parkourlrc/pcb-Szymon423--Mesa-7i96s-P1-Port-BOB-06d0a3034d/01-Hardware/db25-bob-io/pcb.step

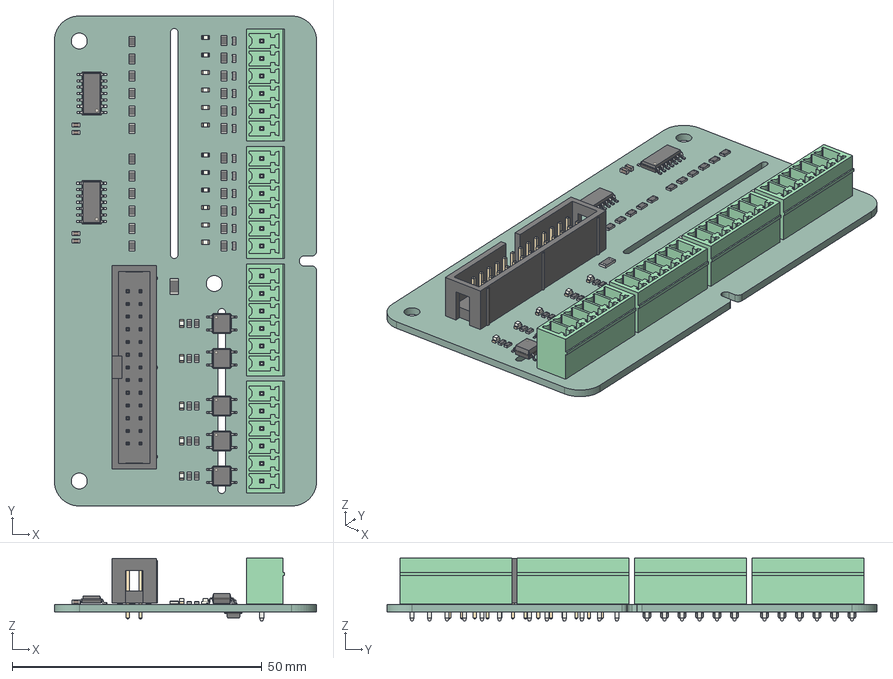
[picture p4: CAD file, 2026-04-16]
01-Hardware/db25-bob-io/pcb.step
52.5 x 98.0 x 12.6 mm
L_0603_1608Metric x 12
R_0805_2012Metric x 24
PhoenixContact_MCV_1,5_6-G-3.5_1x06_P3.50mm_Vertical x 4
C_0603_1608Metric x 4
LED_0603_1608Metric x 17
R_0603_1608Metric x 10
SOP-4_3.8x4.1mm_P2.54mm x 5
Fuse_1206_3216Metric
SO-14_3.9x8.65mm_P1.27mm x 2
IDC-Header_2x13_P2.54mm_Vertical
D_SOD-123F x 12
db25-bob-io_PCB
