parkourlrc/pcb-Szymon423--Mesa-7i96s-P1-Port-BOB-06d0a3034d/02-Mounting-Plate/3D-Printing/print.3mf

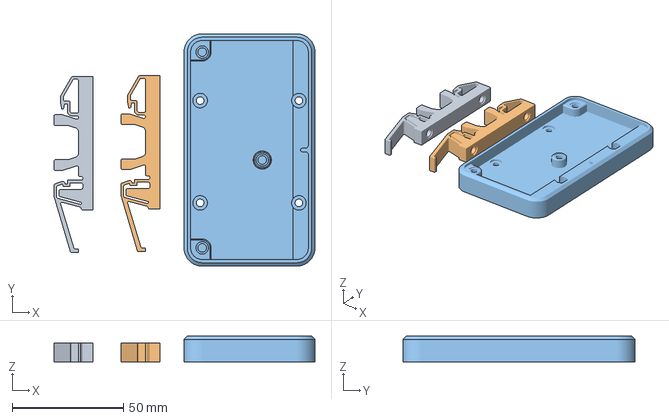
[picture p5: CAD file, 2026-10-19]
02-Mounting-Plate/3D-Printing/print.3mf
117.3 x 104.4 x 11.6 mm
02.stl
01.stl
