parkourlrc/pcb-Szymon423--Mesa-7i96s-P1-Port-BOB-06d0a3034d/02-Mounting-Plate/3D-Printing/01.stl

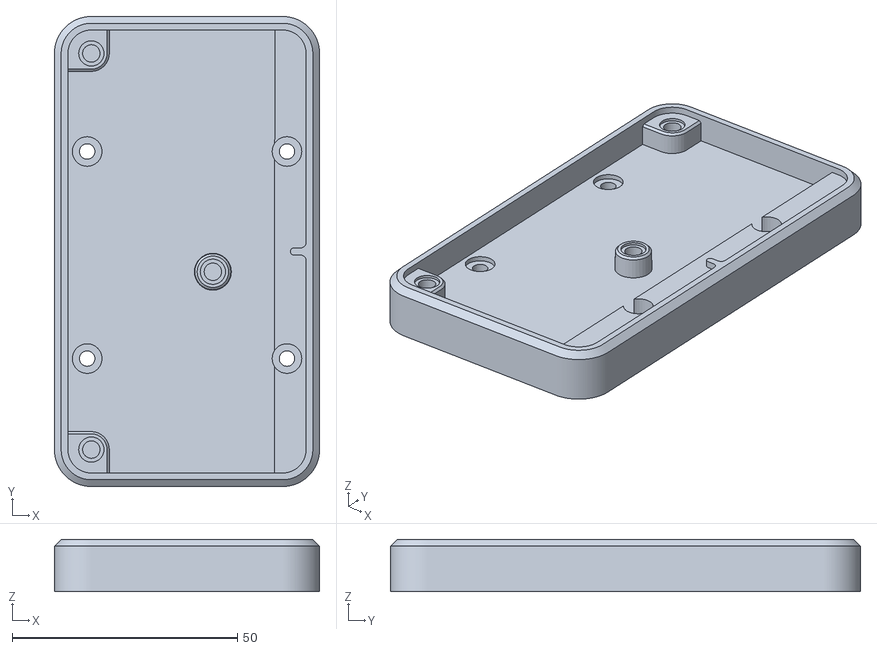
[picture p6: CAD file, 2026-04-16]
02-Mounting-Plate/3D-Printing/01.stl
58.9 x 104.4 x 11.6
