parkourlrc/pcb-Szymon423--Mesa-7i96s-P1-Port-BOB-06d0a3034d/02-Mounting-Plate/3D-Printing/02.stl

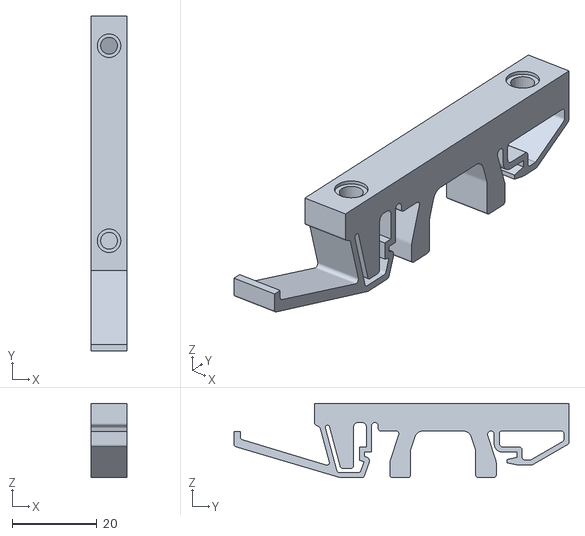
[picture p7: CAD file, 2026-04-16]
02-Mounting-Plate/3D-Printing/02.stl
8.52 x 79.0 x 17.5
