parkourlrc/pcb-Szymon423--Mesa-7i96s-P1-Port-BOB-06d0a3034d/(list of files, cad)

Other CAD files:
02-Mounting-Plate/model.blend
