parkourlrc/pcb-Szymon423--Mesa-7i96s-P1-Port-BOB-06d0a3034d/01-Hardware/db25-bob-io/db25-bob-io.kicad_pcb

## KiCad design 01-Hardware/db25-bob-io/db25-bob-io.kicad_pcb (2026-04-16)

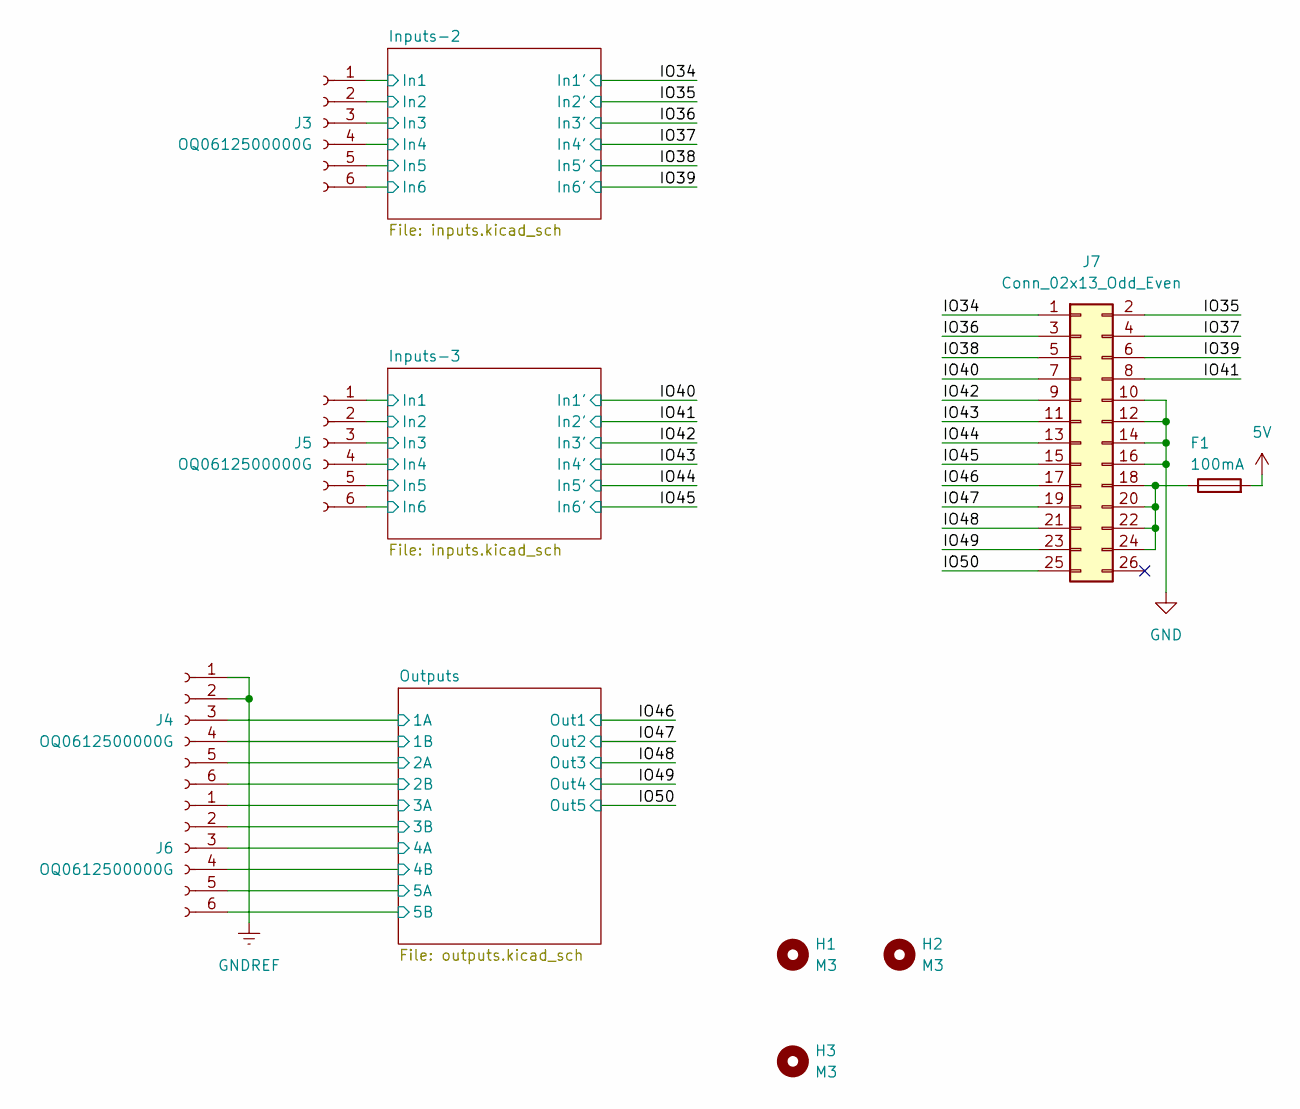
[picture p8: schematic db25-bob-io.kicad_sch]

Parts:
F1: 100mA; Fuse_1206_3216Metric
H1, H2, H3: M3; MountingHole_3.2mm_M3
J3, J4, J5, J6: OQ0612500000G; PhoenixContact_MCV_1,5_6-G-3.5_1x06_P3.50mm_Vertical
J7: Conn_02x13_Odd_Even; IDC-Header_2x13_P2.54mm_Vertical

Connections:
5V: F1.2; also elsewhere on the board
/IO34: J7.1; also elsewhere on the board
/IO35: J7.2; also elsewhere on the board
/IO36: J7.3; also elsewhere on the board
/IO37: J7.4; also elsewhere on the board
/IO38: J7.5; also elsewhere on the board
/IO39: J7.6; also elsewhere on the board
/IO40: J7.7; also elsewhere on the board
/IO41: J7.8; also elsewhere on the board
/IO42: J7.9; also elsewhere on the board
/IO43: J7.11; also elsewhere on the board
/IO44: J7.13; also elsewhere on the board
/IO45: J7.15; also elsewhere on the board
/IO46: J7.17; also elsewhere on the board
/IO47: J7.19; also elsewhere on the board
/IO48: J7.21; also elsewhere on the board
/IO49: J7.23; also elsewhere on the board
/IO50: J7.25; also elsewhere on the board
/Inputs-2/In1: J3.1; also elsewhere on the board
/Inputs-2/In2: J3.2; also elsewhere on the board
/Inputs-2/In3: J3.3; also elsewhere on the board
/Inputs-2/In4: J3.4; also elsewhere on the board
/Inputs-2/In5: J3.5; also elsewhere on the board
/Inputs-2/In6: J3.6; also elsewhere on the board
/Inputs-3/In1: J5.1; also elsewhere on the board
/Inputs-3/In2: J5.2; also elsewhere on the board
/Inputs-3/In3: J5.3; also elsewhere on the board
/Inputs-3/In4: J5.4; also elsewhere on the board
/Inputs-3/In5: J5.5; also elsewhere on the board
/Inputs-3/In6: J5.6; also elsewhere on the board
/Outputs/1A: J4.3; also elsewhere on the board
/Outputs/1B: J4.4; also elsewhere on the board
/Outputs/2A: J4.5; also elsewhere on the board
/Outputs/2B: J4.6; also elsewhere on the board
/Outputs/3A: J6.1; also elsewhere on the board
/Outputs/3B: J6.2; also elsewhere on the board
/Outputs/4A: J6.3; also elsewhere on the board
/Outputs/4B: J6.4; also elsewhere on the board
/Outputs/5A: J6.5; also elsewhere on the board
/Outputs/5B: J6.6; also elsewhere on the board
GND: J7.10, J7.12, J7.14, J7.16; also elsewhere on the board
GNDREF: J4.1, J4.2; also elsewhere on the board
unnamed: F1.1, J7.18, J7.20, J7.22, J7.24

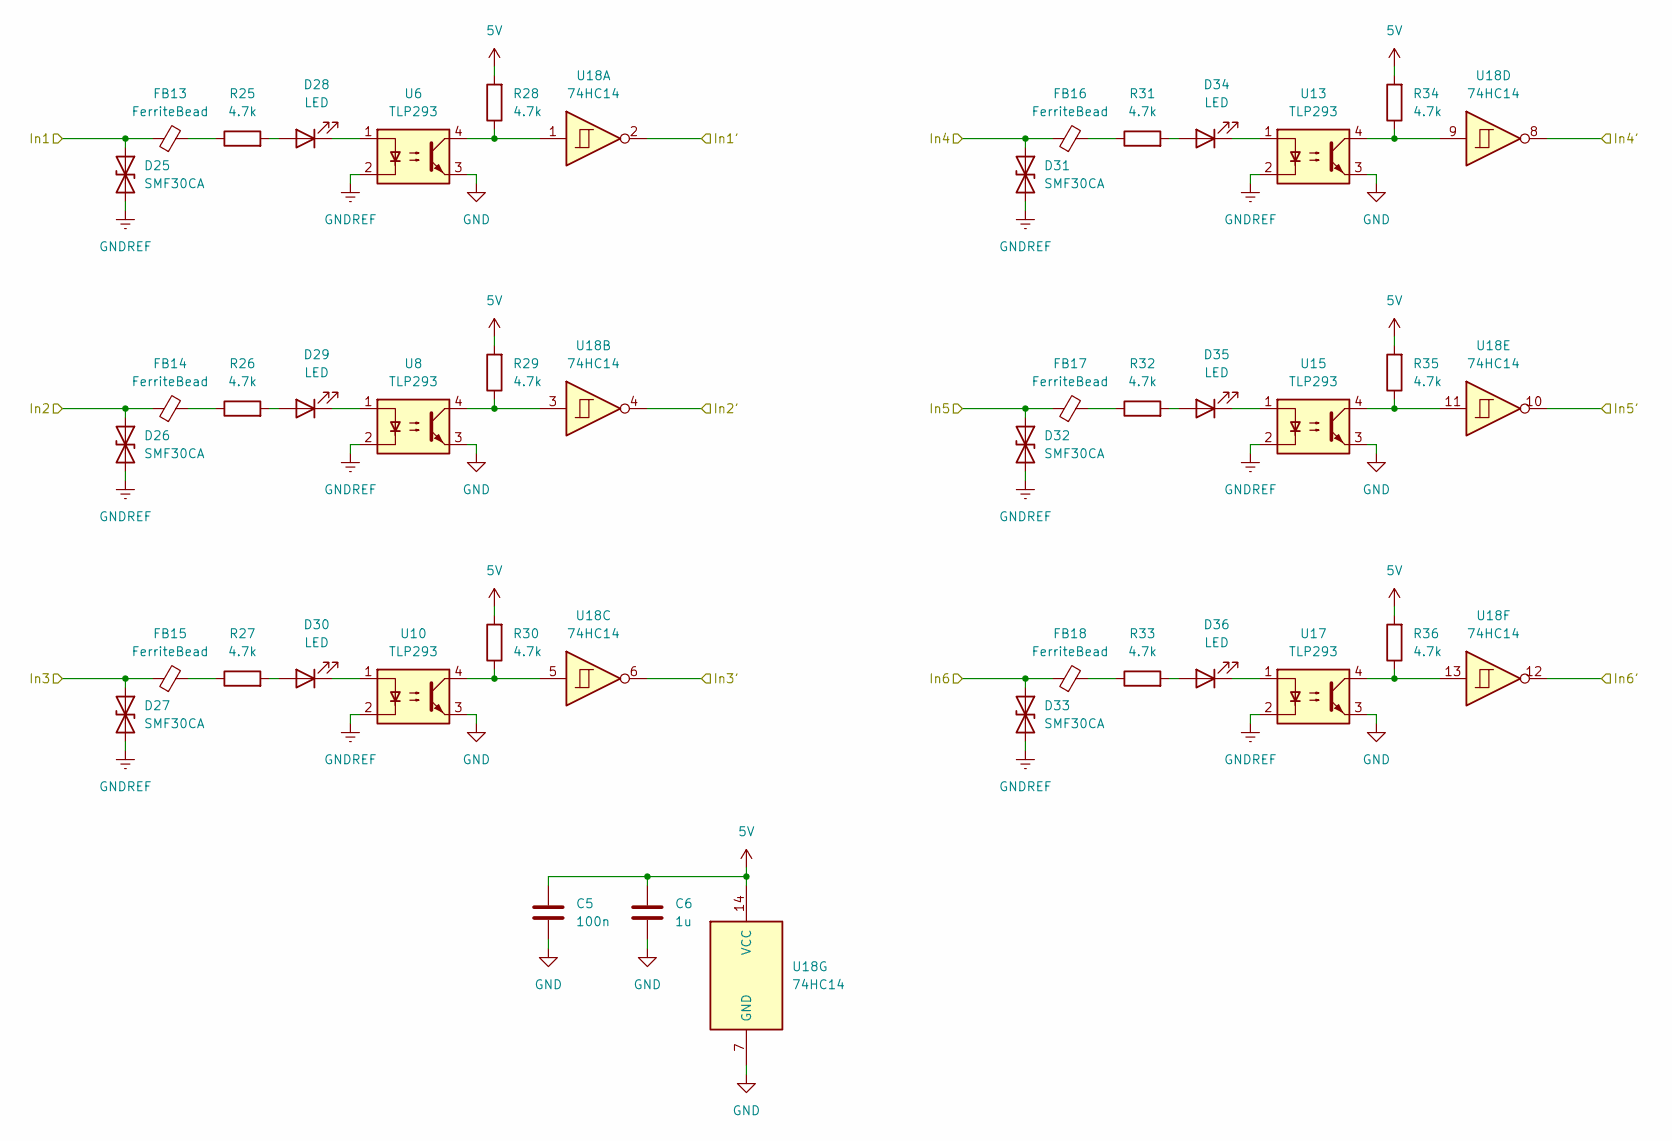
[picture p9: schematic inputs.kicad_sch]

Parts:
C5: 100n; C_0603_1608Metric
C6: 1u; C_0603_1608Metric
D25, D26, D27, D31, D32, D33: SMF30CA; D_SOD-123F
D28, D29, D30, D34, D35, D36: LED; LED_0603_1608Metric
FB13, FB14, FB15, FB16, FB17, FB18: FerriteBead; L_0603_1608Metric
R25, R26, R27, R28, R29, R30, R31, R32, R33, R34, R35, R36: 4.7k; R_0805_2012Metric
U6, U8, U10, U13, U15, U17: TLP293; SOIC-4_4.55x2.6mm_P1.27mm
U18: 74HC14; SO-14_3.9x8.65mm_P1.27mm

Connections:
5V: C5.1, C6.1, R28.2, R29.2, R30.2, R34.2, R35.2, R36.2, U18.14 (VCC); also elsewhere on the board
/IO40: U18.2; also elsewhere on the board
/IO41: U18.4; also elsewhere on the board
/IO42: U18.6; also elsewhere on the board
/IO43: U18.8; also elsewhere on the board
/IO44: U18.10; also elsewhere on the board
/IO45: U18.12; also elsewhere on the board
/Inputs-3/In1: D25.1 (A1), FB13.1; also elsewhere on the board
/Inputs-3/In2: D26.1 (A1), FB14.1; also elsewhere on the board
/Inputs-3/In3: D27.1 (A1), FB15.1; also elsewhere on the board
/Inputs-3/In4: D31.1 (A1), FB16.1; also elsewhere on the board
/Inputs-3/In5: D32.1 (A1), FB17.1; also elsewhere on the board
/Inputs-3/In6: D33.1 (A1), FB18.1; also elsewhere on the board
GND: C5.2, C6.2, U6.3, U8.3, U10.3, U13.3, U15.3, U17.3, U18.7 (GND); also elsewhere on the board
GNDREF: D25.2 (A2), D26.2 (A2), D27.2 (A2), D31.2 (A2), D32.2 (A2), D33.2 (A2), U6.2, U8.2, U10.2, U13.2, U15.2, U17.2; also elsewhere on the board
unnamed: D28.2 (A), R25.2
unnamed: D28.1 (K), U6.1
unnamed: D29.2 (A), R26.2
unnamed: D29.1 (K), U8.1
unnamed: D30.2 (A), R27.2
unnamed: D30.1 (K), U10.1
unnamed: D34.2 (A), R31.2
unnamed: D34.1 (K), U13.1
unnamed: D35.2 (A), R32.2
unnamed: D35.1 (K), U15.1
unnamed: D36.2 (A), R33.2
unnamed: D36.1 (K), U17.1
unnamed: FB13.2, R25.1
unnamed: FB14.2, R26.1
unnamed: FB15.2, R27.1
unnamed: FB16.2, R31.1
unnamed: FB17.2, R32.1
unnamed: FB18.2, R33.1
unnamed: R28.1, U6.4, U18.1
unnamed: R29.1, U8.4, U18.3
unnamed: R30.1, U10.4, U18.5
unnamed: R34.1, U13.4, U18.9
unnamed: R35.1, U15.4, U18.11
unnamed: R36.1, U17.4, U18.13

Parts of its further copies:
C3: 100n; C_0603_1608Metric
C4: 1u; C_0603_1608Metric
D13, D14, D15, D19, D20, D21: SMF30CA; D_SOD-123F
D16, D17, D18, D22, D23, D24: LED; LED_0603_1608Metric
FB7, FB8, FB9, FB10, FB11, FB12: FerriteBead; L_0603_1608Metric
R13, R14, R15, R16, R17, R18, R19, R20, R21, R22, R23, R24: 4.7k; R_0805_2012Metric
U7, U9, U12, U14, U16, U19: TLP293; SOIC-4_4.55x2.6mm_P1.27mm
U11: 74HC14; SO-14_3.9x8.65mm_P1.27mm

Connections of its further copies:
5V: C3.1, C4.1, R16.2, R17.2, R18.2, R22.2, R23.2, R24.2, U11.14 (VCC); also elsewhere on the board
/IO34: U11.2; also elsewhere on the board
/IO35: U11.4; also elsewhere on the board
/IO36: U11.6; also elsewhere on the board
/IO37: U11.8; also elsewhere on the board
/IO38: U11.10; also elsewhere on the board
/IO39: U11.12; also elsewhere on the board
/Inputs-2/In1: D13.1 (A1), FB7.1; also elsewhere on the board
/Inputs-2/In2: D14.1 (A1), FB8.1; also elsewhere on the board
/Inputs-2/In3: D15.1 (A1), FB9.1; also elsewhere on the board
/Inputs-2/In4: D19.1 (A1), FB10.1; also elsewhere on the board
/Inputs-2/In5: D20.1 (A1), FB11.1; also elsewhere on the board
/Inputs-2/In6: D21.1 (A1), FB12.1; also elsewhere on the board
GND: C3.2, C4.2, U7.3, U9.3, U11.7 (GND), U12.3, U14.3, U16.3, U19.3; also elsewhere on the board
GNDREF: D13.2 (A2), D14.2 (A2), D15.2 (A2), D19.2 (A2), D20.2 (A2), D21.2 (A2), U7.2, U9.2, U12.2, U14.2, U16.2, U19.2; also elsewhere on the board
unnamed: D16.2 (A), R13.2
unnamed: D16.1 (K), U7.1
unnamed: D17.2 (A), R14.2
unnamed: D17.1 (K), U9.1
unnamed: D18.2 (A), R15.2
unnamed: D18.1 (K), U12.1
unnamed: D22.2 (A), R19.2
unnamed: D22.1 (K), U14.1
unnamed: D23.2 (A), R20.2
unnamed: D23.1 (K), U16.1
unnamed: D24.2 (A), R21.2
unnamed: D24.1 (K), U19.1
unnamed: FB7.2, R13.1
unnamed: FB8.2, R14.1
unnamed: FB9.2, R15.1
unnamed: FB10.2, R19.1
unnamed: FB11.2, R20.1
unnamed: FB12.2, R21.1
unnamed: R16.1, U7.4, U11.1
unnamed: R17.1, U9.4, U11.3
unnamed: R18.1, U11.5, U12.4
unnamed: R22.1, U11.9, U14.4
unnamed: R23.1, U11.11, U16.4
unnamed: R24.1, U11.13, U19.4

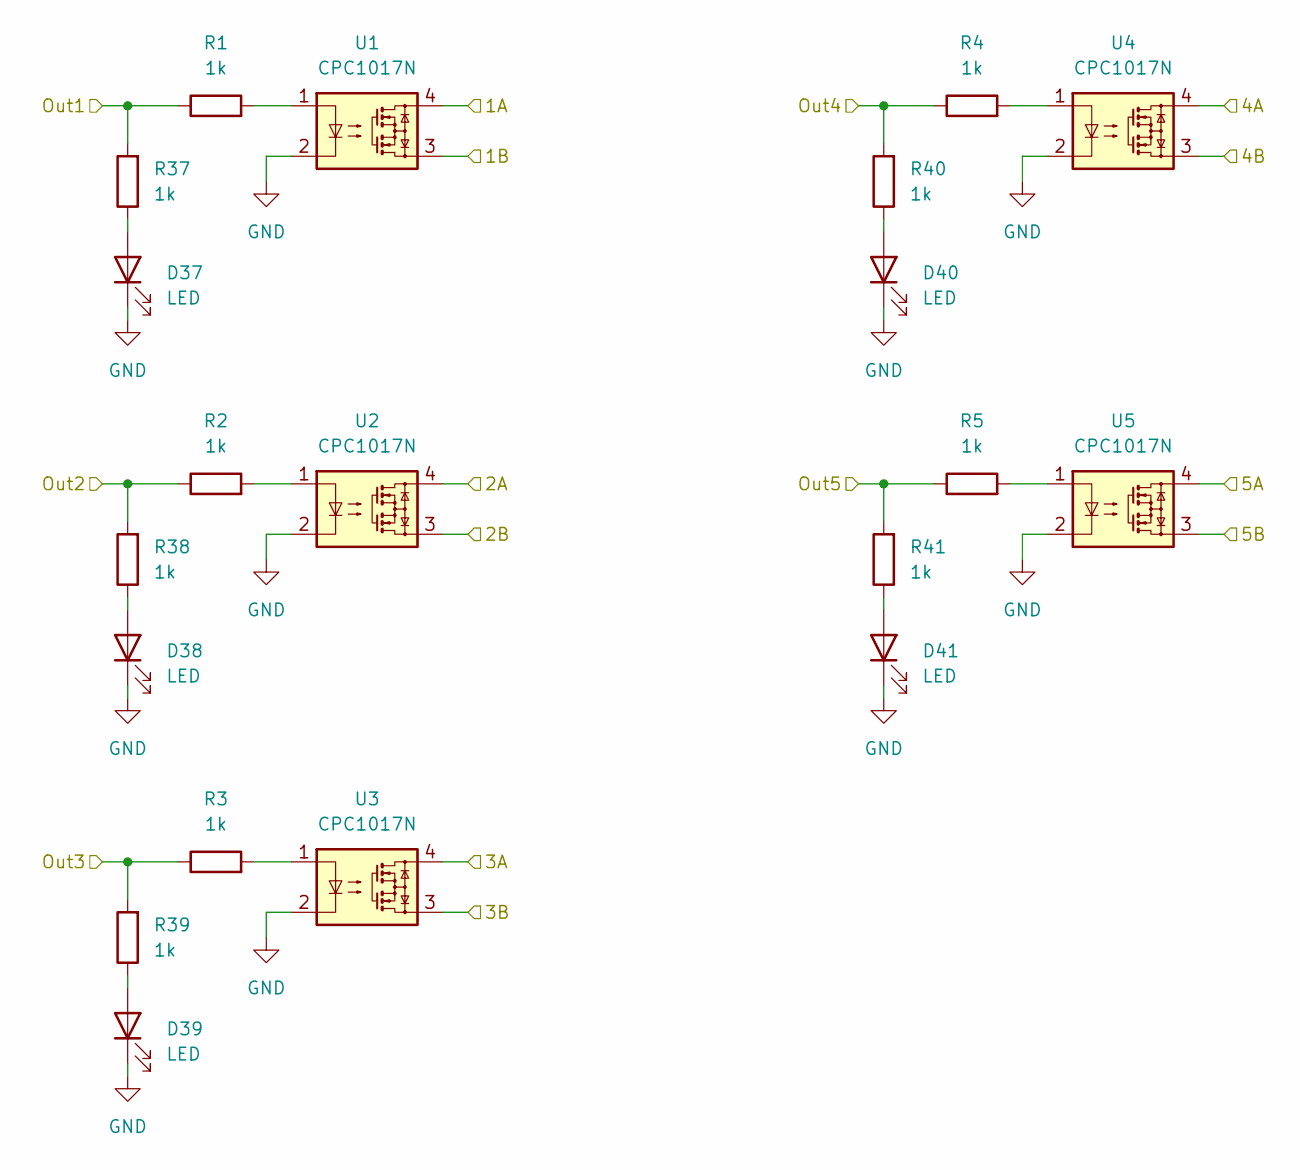
[picture p10: schematic outputs.kicad_sch]

Parts:
D37, D38, D39, D40, D41: LED; LED_0603_1608Metric
R1, R2, R3, R4, R5, R37, R38, R39, R40, R41: 1k; R_0603_1608Metric
U1, U2, U3, U4, U5: CPC1017N; SOP-4_3.8x4.1mm_P2.54mm

Connections:
/IO46: R1.1, R37.2; also elsewhere on the board
/IO47: R2.1, R38.2; also elsewhere on the board
/IO48: R3.1, R39.2; also elsewhere on the board
/IO49: R4.1, R40.2; also elsewhere on the board
/IO50: R5.1, R41.2; also elsewhere on the board
/Outputs/1A: U1.4; also elsewhere on the board
/Outputs/1B: U1.3; also elsewhere on the board
/Outputs/2A: U2.4; also elsewhere on the board
/Outputs/2B: U2.3; also elsewhere on the board
/Outputs/3A: U3.4; also elsewhere on the board
/Outputs/3B: U3.3; also elsewhere on the board
/Outputs/4A: U4.4; also elsewhere on the board
/Outputs/4B: U4.3; also elsewhere on the board
/Outputs/5A: U5.4; also elsewhere on the board
/Outputs/5B: U5.3; also elsewhere on the board
GND: D37.1 (K), D38.1 (K), D39.1 (K), D40.1 (K), D41.1 (K), U1.2, U2.2, U3.2, U4.2, U5.2; also elsewhere on the board
unnamed: D37.2 (A), R37.1
unnamed: D38.2 (A), R38.1
unnamed: D39.2 (A), R39.1
unnamed: D40.2 (A), R40.1
unnamed: D41.2 (A), R41.1
unnamed: R1.2, U1.1
unnamed: R2.2, U2.1
unnamed: R3.2, U3.1
unnamed: R4.2, U4.1
unnamed: R5.2, U5.1

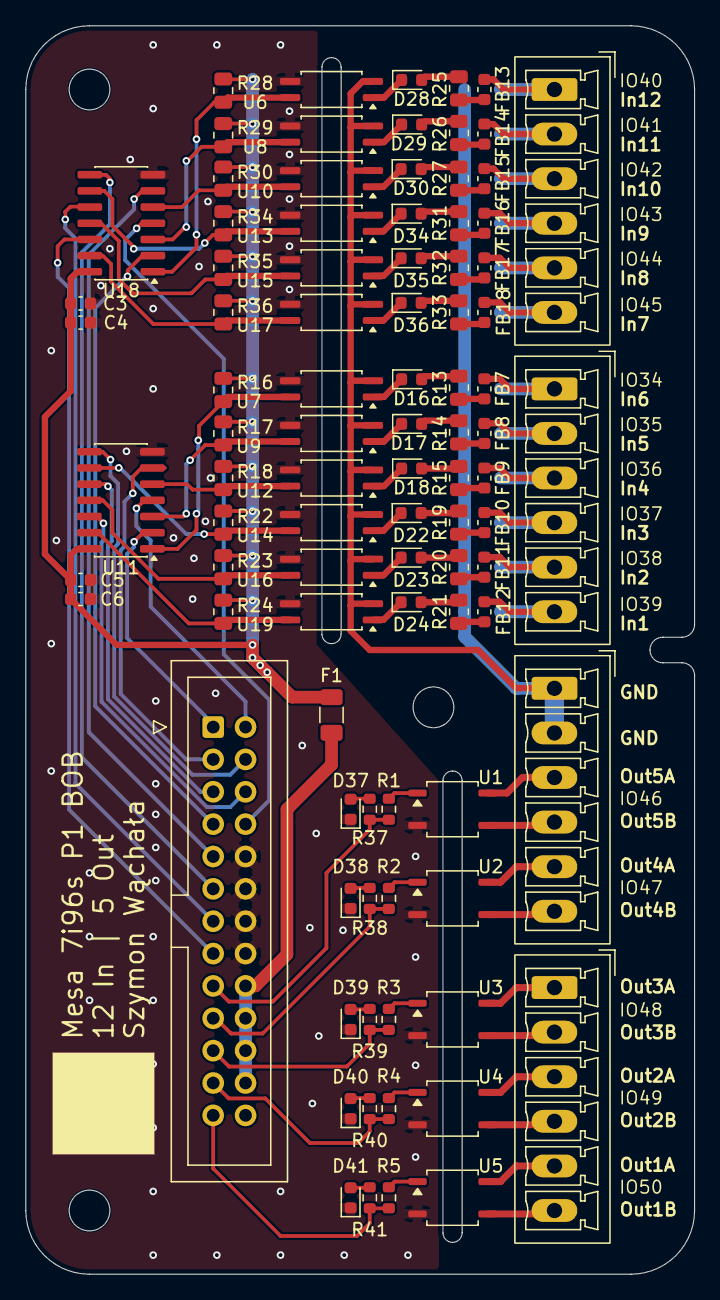
[picture p11: board db25-bob-io.kicad_pcb from above]

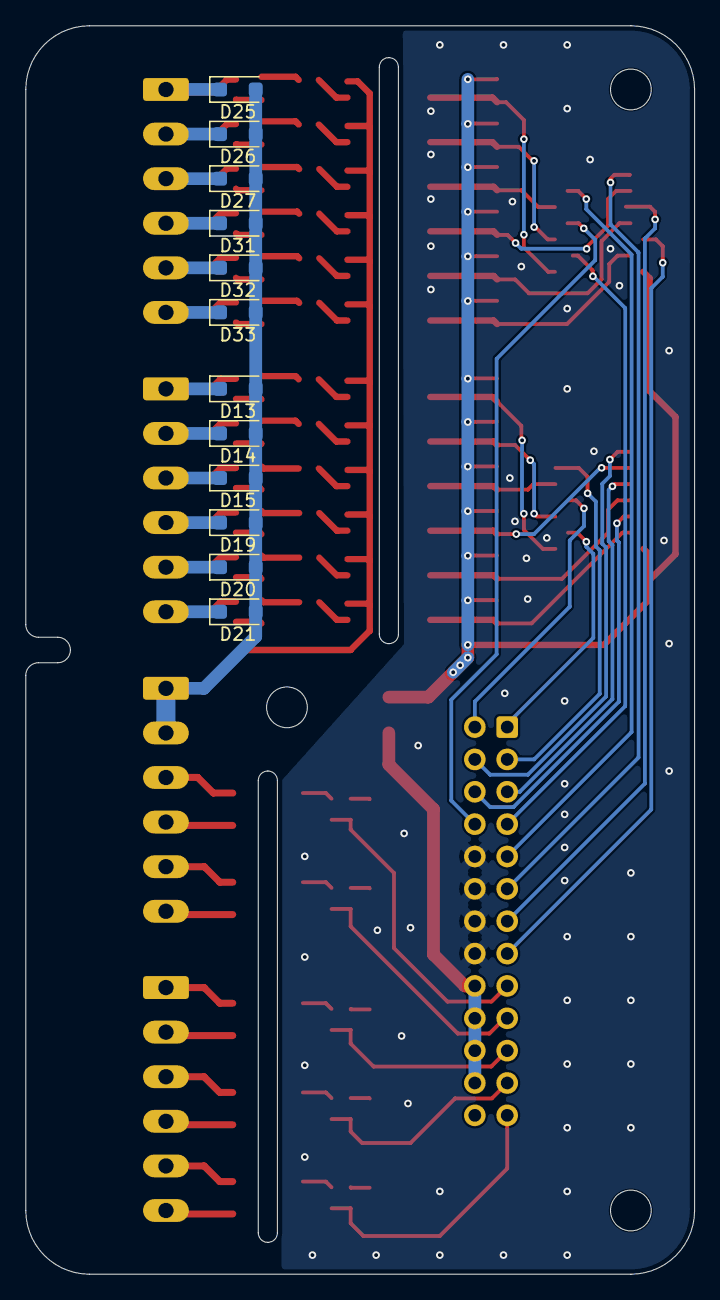
[picture p12: board db25-bob-io.kicad_pcb from below]

Board: 2 copper layers, 52.5 x 98.0 mm, 107 parts (12 on the bottom side), 101 nets.
