parkourlrc/pcb-Szymon423--Mesa-7i96s-P1-Port-BOB-06d0a3034d/(notices)

Notices in the files:
README.md:
License: CC BY 4.0
